Alxb85/pellet-feeder-arduino/aufbau.jpg

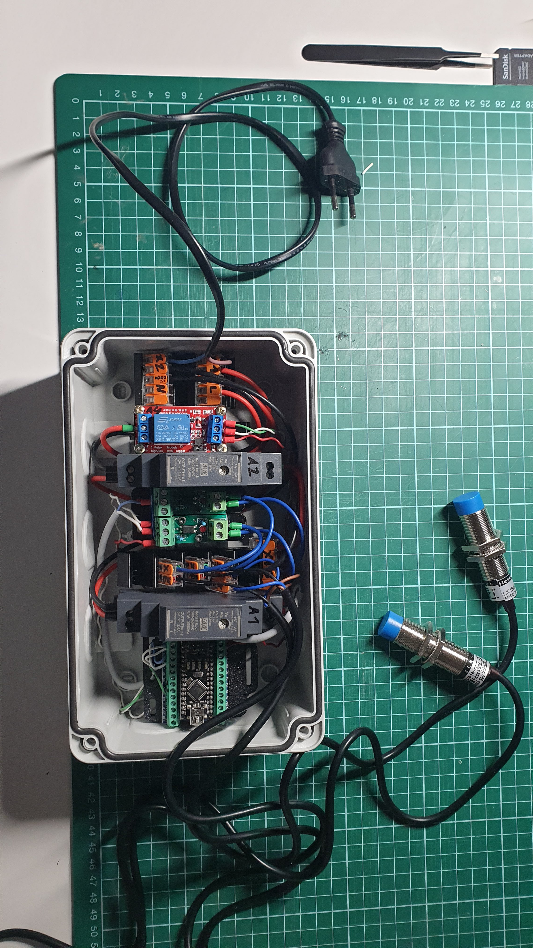
aufbau.jpg
