Alxb85/pellet-feeder-arduino/KLEMMENPLAN.pdf

Klemmenplan

X1 – Phase L (230 V)

Klemme | Anschluss
X1:1 | Zuleitung L (Steckdose)
X1:2 | L → 12 V Netzteil
X1:3 | L → 5 V Netzteil
X1:4 | L → Relais COM
X1:5 | frei

X2 – Neutralleiter N (230 V)

Klemme | Anschluss
X2:1 | Zuleitung N (Steckdose)
X2:2 | N → 12 V Netzteil
X2:3 | N → 5 V Netzteil
X2:4 | N → Motor
X2:5 | frei

X3 – +12 V

Klemme | Anschluss
X3:1 | +12 V vom Netzteil
X3:2 | Sensor unten braun
X3:3 | Sensor oben braun
X3:4 | PC817 INPUT+ (unten)
X3:5 | PC817 INPUT+ (oben)

X4 – 0 V / GND

Klemme | Anschluss
X4:1 | 0 V Netzteil
X4:2 | Sensor unten blau
X4:3 | Sensor oben blau

X5 – Sensor unten Signal

Klemme | Anschluss
X5:1 | PC817 INPUT− (unten)
X5:2 | Sensor unten schwarz

X6 – Sensor oben Signal

Klemme | Anschluss
X6:1 | PC817 INPUT− (oben)
X6:2 | Sensor oben schwarz

Direkte Verbindungen

- PC817 (unten) OUT → Arduino D2
- PC817 (oben) OUT → Arduino D3
- Relais IN → Arduino D8
- Relais DC+ → 5 V Arduino
- Relais DC− → GND Arduino

Motoranschluss

- L: Steckdose → X1 → Relais COM → Relais NO → Motor
- N: Steckdose → X2 → Motor

Funktionsbeschreibung

- Fass leer (unten frei) → Nachfüllen nach Verzögerung
- Fass voll (oben aktiv) → Motor AUS
- Oben aktiv & unten frei → Fehler, kein Nachfüllen
