Alxb85/pellet-feeder-arduino/Bauteile.pdf

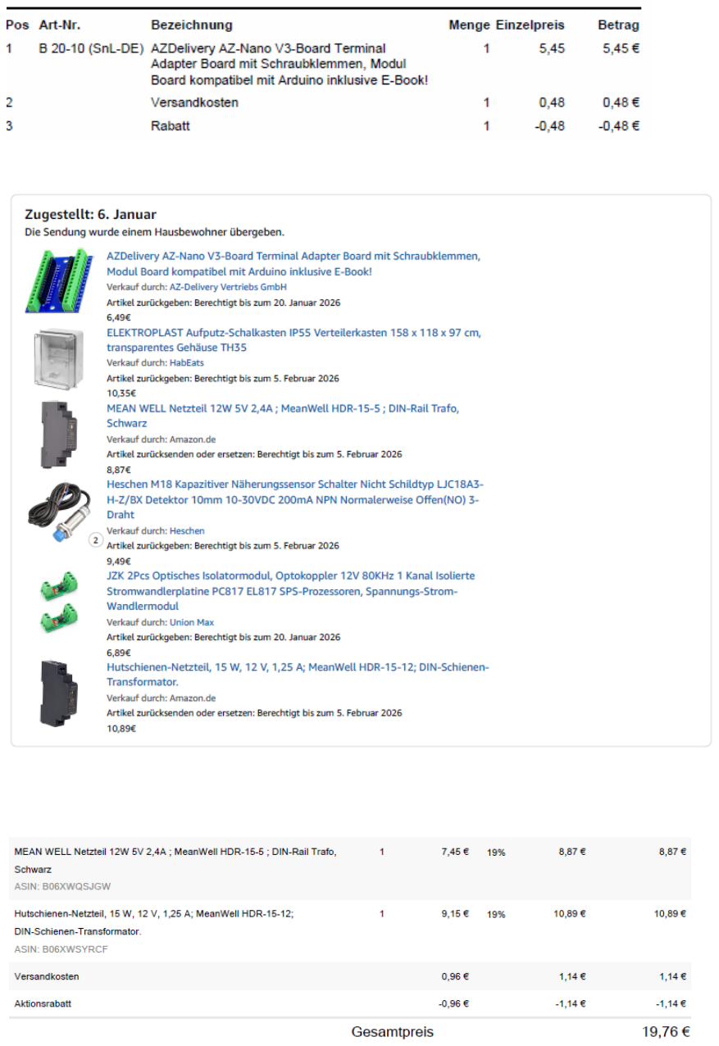
[picture p2: page 1]

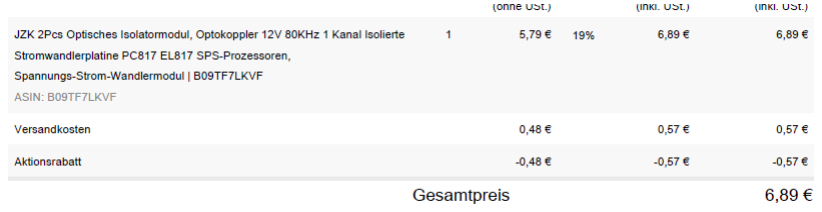
[picture p3: figure]
